Torxgewinde/Irrigation_Controller/pictures/IMG_1158.JPG

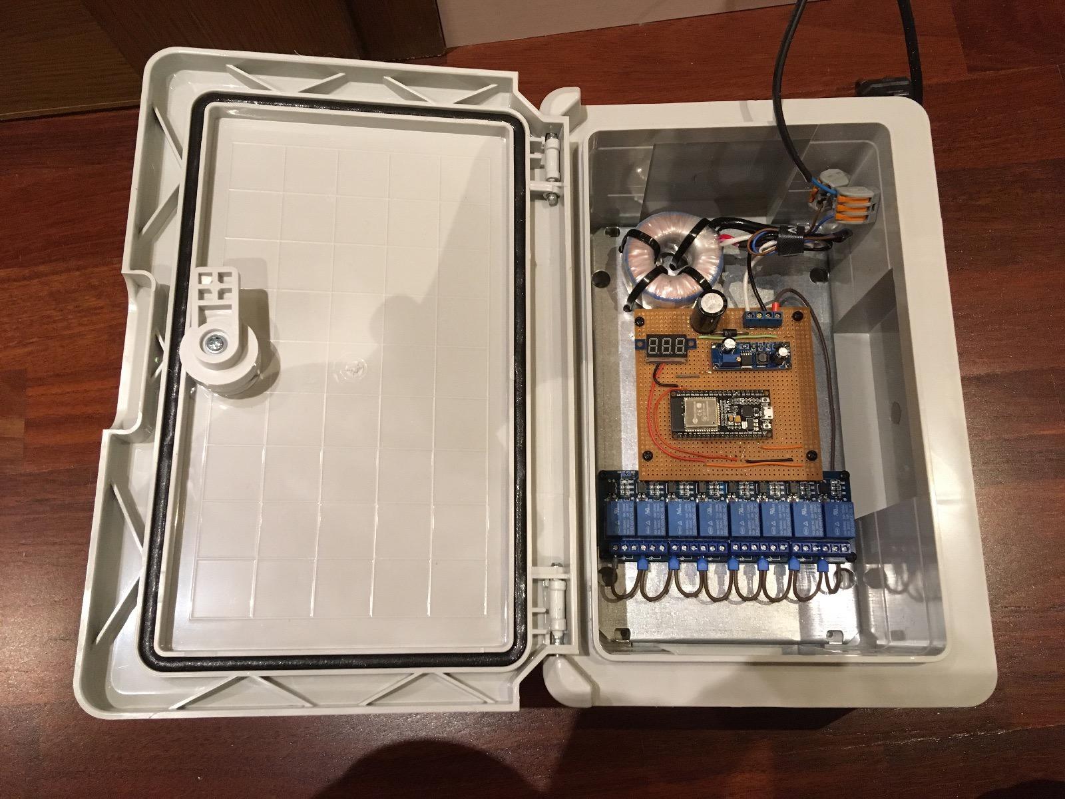
pictures/IMG_1158.JPG
