Torxgewinde/Irrigation_Controller/pictures/Irrigation_schem.jpg

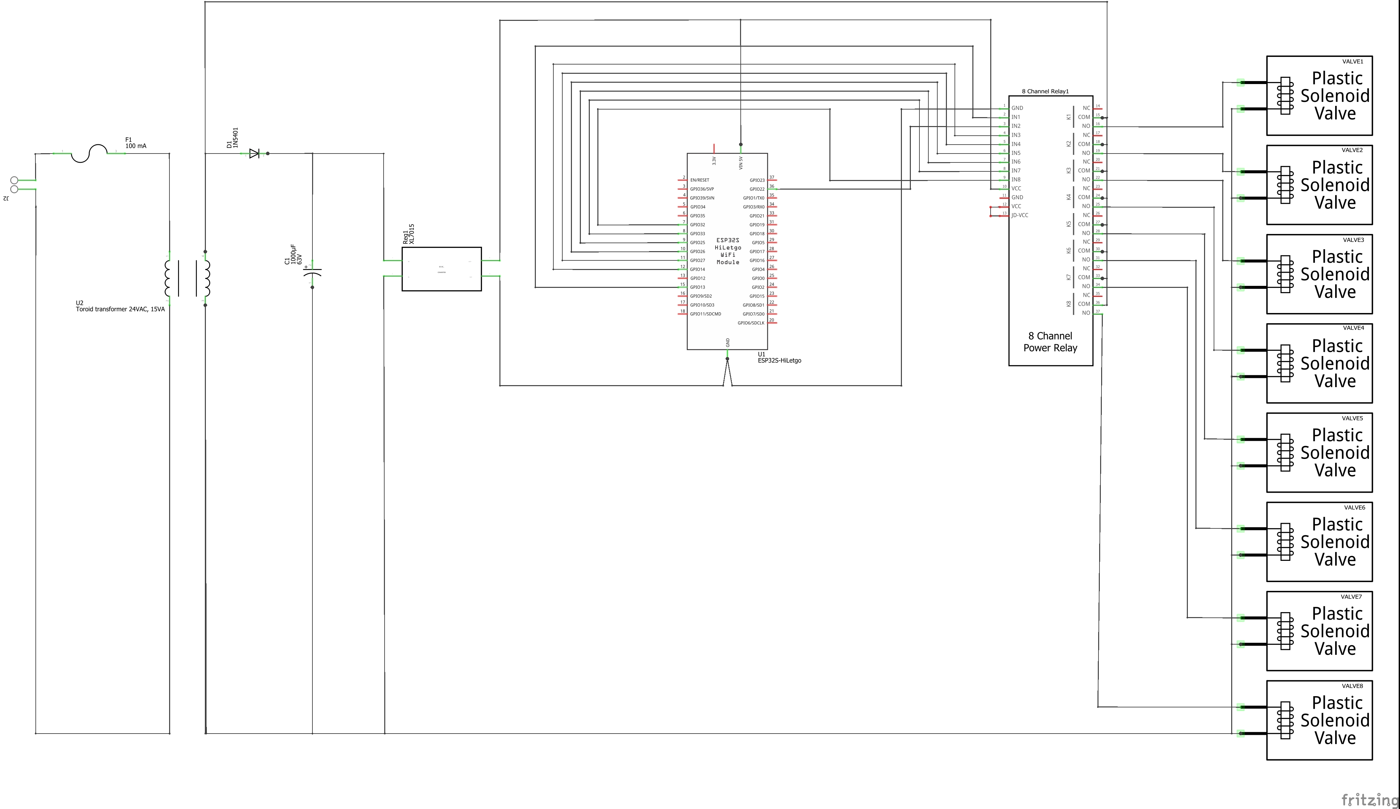
pictures/Irrigation_schem.jpg
