Torxgewinde/Irrigation_Controller/pictures/Superimposed.jpg

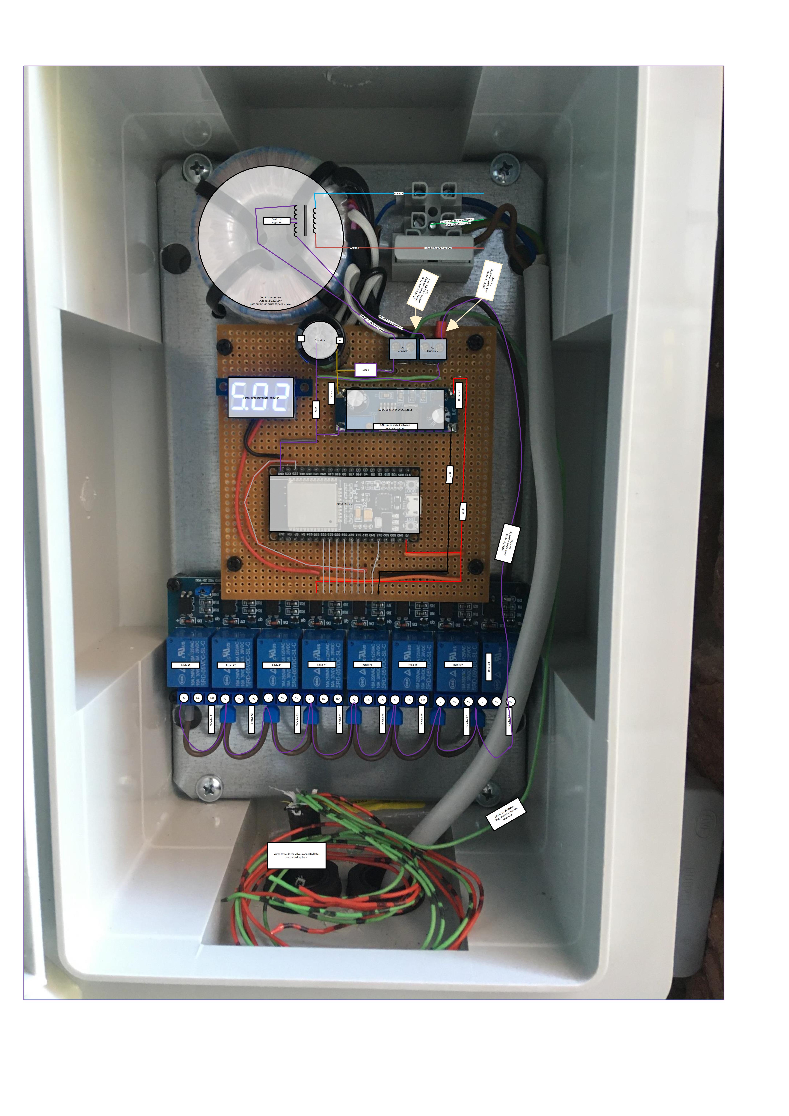
pictures/Superimposed.jpg
