Torxgewinde/Irrigation_Controller/(commit log)

2020-04-26 Fuse holder and full assembly picture added
2020-04-26 Included picture of final assembly
    Especially the fuse-holder in that picture is important.
2020-04-26 Bumped up versions of Arduino IDE and libraries
2020-09-06 added picture of closed enclosure
2021-05-07 Added schematic
2021-12-12 Changes for Arduino-ESP32, adding NTP
    publish messages not from the receive routine
    set internal time via NTP
    set last-will-testament
2021-12-12 Switch to Arduino-ESP32 V2.0.1
    Bump up version to Arduino ESP32 V2.0.1
2021-12-13 Disable WiFi power save, cleaned up
