Torxgewinde/Irrigation_Controller/pictures/IMG_1152.JPG

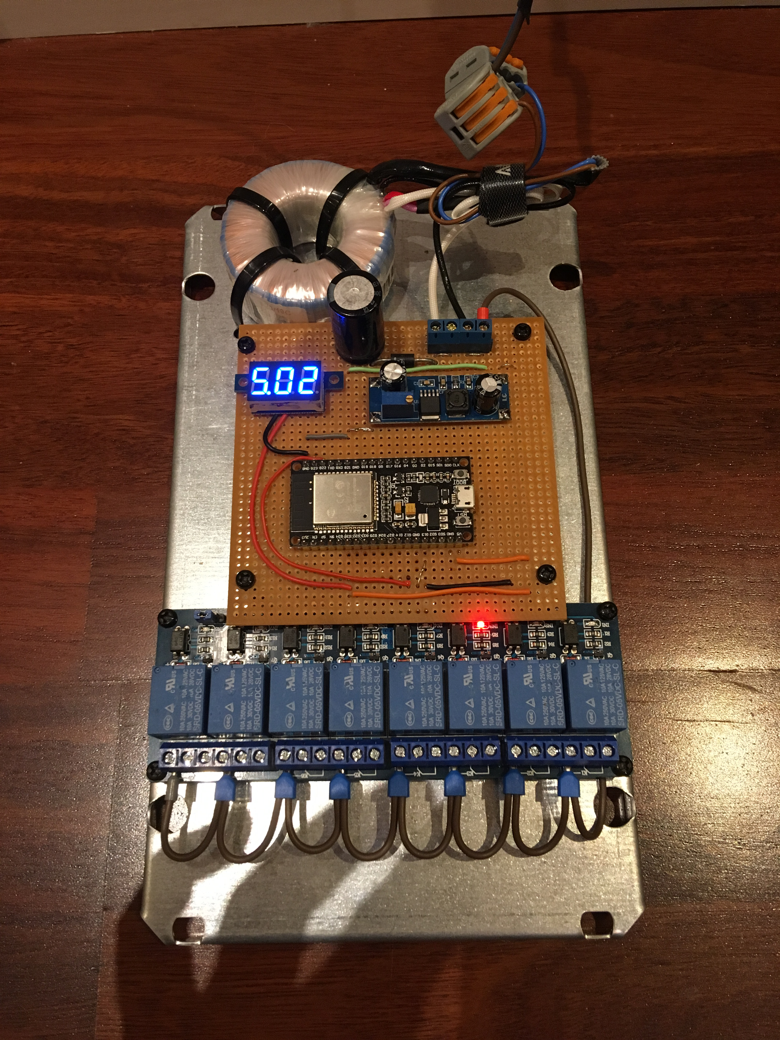
pictures/IMG_1152.JPG
